ctag-fh-kiel/troll-8/readme.md

CTAG (http://www.creative-technologies.de/troll8/)
# CTAG TROLL8
TROLL8 is an Arduino Based μSynth development platform.
This repo contains:
  - [KiCad](http://kicad.org/) PCB design files ([schematics as pdf](https://github.com/ctag-fh-kiel/troll-8/blob/master/Docs/TROLL-8-Schematics.pdf))
	- You may order the PCB [here](http://dirtypcbs.com/store/designer/details/8229/2509/gerber-zip)
  - Silkscreen design files
  - Arduino examples
    - Midi controller (requires [hairless midi](http://projectgus.github.io/hairless-midiserial/))
	- Drum machine with Synth
    - ePiano (velocity sensitive)    
	- Step sequencer
    - Linear sequencer
    - Teensy 3.1 synthesizer
    - LED example
    - and more...
  - A short [presentation on TROLL8](https://github.com/ctag-fh-kiel/troll-8/blob/master/Docs/Talk_AmIEs2016_Manzke.pdf)
# Known Bugs
  - PCB design: Rotary knobs are not evenly spaced
# Authors / License
  - Authors are Robert Manzke (Main Author, FH-Kiel), Henrik Langer (FH-Kiel), Alexander Konradi (FH-Kiel)
  - Licensed under Creative Commons Attribution-NonCommercial-ShareAlike 4.0 International License
# Acknoledgements
  - All Arduino examples make use of the amazing [Mozzi Sound Library](http://sensorium.github.io/Mozzi/)
# Media
CTAG (https://www.youtube.com/watch?v=BTMn9AdLmPc&t=76s)
av500 (https://www.youtube.com/watch?v=JXBJwmJRRko)
Gearnews German (https://www.gearnews.de/creative-technology-%C2%B5synth/)
## [Gearnews English (click here)](https://www.gearnews.com/troll8-micro-sized-synthesizer-sequencer-controller-drum-machine/)
