ctag-fh-kiel/troll-8/PCB/bom.xlsx

Mouser | Id | Designator | Package | Quantity | Designation | Manuf ID | Notes
x | 1 | C103,C102,C101,C201,C202,C401,C502,C501,C601 | C_0603_HandSoldering | 9 | 100n | C0603C104K5RACTU (https://www.mouser.de/Search/ProductDetail.aspx)
x | 2 | C104, C105 | C_0603_HandSoldering | 2 | 220n | 02016D224KAT2A (http://www.mouser.de/ProductDetail/AVX/02016D224KAT2A/)
x | 3 | C106 | C_0603_HandSoldering | 1 | 1n | GCM188R71H102KA37D (https://www.mouser.de/Search/ProductDetail.aspx)
x | 4 | C301,C302 | c_elec_4x5.7 | 2 | 10u | EEE-FC1C100R (https://www.mouser.de/Search/ProductDetail.aspx)
x | 5 | CON301 | BARELL_CLIFF_DC10L | 1 | BARREL_JACK | PJ-102B (http://www.mouser.de/ProductDetail/CUI/PJ-102B/)
x | 6 | D201,D202,D203,D204,D205,D206,D207,D208,D209,D210,D211,D212,D213,D214,D215,D216,D601,D602,D603,D604,D605,D606,D607,D608 | LED-0603 | 24 | LED | 696-SMLLXFP0603SICTR (http://www.mouser.de/ProductDetail/Lumex/SML-LXFP0603SIC-TR/)
x | 7 | D301 | SOD-123 | 1 | D_Schottky | STPS140Z (https://www.mouser.de/Search/ProductDetail.aspx?R=STPS140Zvirtualkey51120000virtualkey511-STPS140Z)
x | 8 | JP101,JP102 | R_0603_HandSoldering | 2 | Jumper_NC_Small | ERJ-3GEY0R00V (https://www.mouser.de/Search/ProductDetail.aspx)
Thonk | 9 | J101 | Thonkicon | 1 | AUOUT | PJ301M-12 | https://www.thonk.co.uk/shop/3-5mm-jacks/
x | 10 | R102 | R_0603_HandSoldering | 1 | 270 | ERJ3EKF2700V (http://de.farnell.com/panasonic-electronic-components/erj3ekf2700v/dickschichtwiderstand-270r-1-0/dp/2303096)
x | 11 | R103,R104 | R_0603_HandSoldering | 2 | 680 | ERJ3EKF6800V (http://de.farnell.com/panasonic-electronic-components/erj3ekf6800v/dickschichtwiderstand-680r-1-0/dp/2303131)
x | 12 | R105 | R_0603_HandSoldering | 1 | 330 | ERJ3EKF3300V (http://de.farnell.com/panasonic-electronic-components/erj3ekf3300v/dickschichtwiderstand-330r-1-0/dp/2303104)
x | 13 | R201,R501,R502,R503,R101 | R_0603_HandSoldering | 5 | 10k | ERJ3EKF1002V (http://de.farnell.com/panasonic-electronic-components/erj3ekf1002v/dickschichtwiderstand-10k-1-0/dp/2303192)
x | 14 | SW601,SW602,SW603,SW604,SW605,SW606,SW607,SW608 | TE-147873-1-Pushbutton | 8 | SW_PUSH | 147873-1
x | 15 | U102 | TSSOP-16_4.4x5mm_Pitch0.65mm | 1 | 74LVC138 | SN74LVC138APWR (http://www.mouser.de/ProductDetail/Texas-Instruments/SN74LVC138APWR/)
x | 16 | U301 | SOT-23-5 | 1 | MCP1755 | MCP1755T-3302E/OT
x | 17 | U401 | SOIC-16_3.9x9.9mm_Pitch1.27mm | 1 | MCP3208 | MCP3008-I/SL (http://www.mouser.de/ProductDetail/Microchip-Technology/MCP3008-I-SL/?qs=sGAEpiMZZMvcAs5GUBtMdQUZaOjaJnKJ) | Using 10 bit for now
x | 18 | U501 | SOIC-8_3.9x4.9mm_Pitch1.27mm | 1 | SST25VF-FLASH | SST25VF080B-80-4I-SAE (http://www.mouser.de/ProductDetail/Microchip-Technology/SST25VF080B-80-4I-SAE/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)
x | 19 | U502 | SOIC-8_3.9x4.9mm_Pitch1.27mm | 1 | 23LC1024-I/SN | 23LC1024-I/SN
x | 20 | U101 | TSSOP-16_4.4x5mm_Pitch0.65mm | 1 | 4050 | CD74HC4050PWR (http://www.mouser.de/ProductDetail/Texas-Instruments/CD74HC4050PWR/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)
x | 21 | U201,U204,U602 | EXBA10P | 3 | EXBA10P-RES | EXB-A10P471J | EXB-A10P331J auch kaufen
x | 22 | P101 | Pin_Header_Straight_2x04 | 1 | SPI_EXT | M20-7830446 (https://www.mouser.de/Search/ProductDetail.aspx)
x | 23 | P102,P103 | Pin_Header_Straight_1x15 | 2 | ~ | M20-7821546
x | 24 | U202,U205 | QFN-24-1EP_4x4mm_Pitch0.5mm | 2 | CAP1188 | CAP1188-1-CP-TR
x | 25 | U601 | QFN-24-1EP_4x4mm_Pitch0.5mm | 1 | MCP23S18-GPIO-QFN-OPEN_DRAIN | MCP23S18-E/MJ
x | 26 | JP103,JP104 | R_0805_HandSoldering | 2 | Jumper_NC_Small | RC0805JR-070RL (https://www.mouser.de/Search/ProductDetail.aspx)
x | 27 | RV401,RV402,RV403,RV404,RV405,RV406,RV407,RV408 | Alps-RK09 | 8 | POT | RK09K1130081 | With center dip
x
