ctag-fh-kiel/troll-8/PCB/troll-8.kicad_pcb

## KiCad design PCB/troll-8.kicad_pcb (2017-11-28)

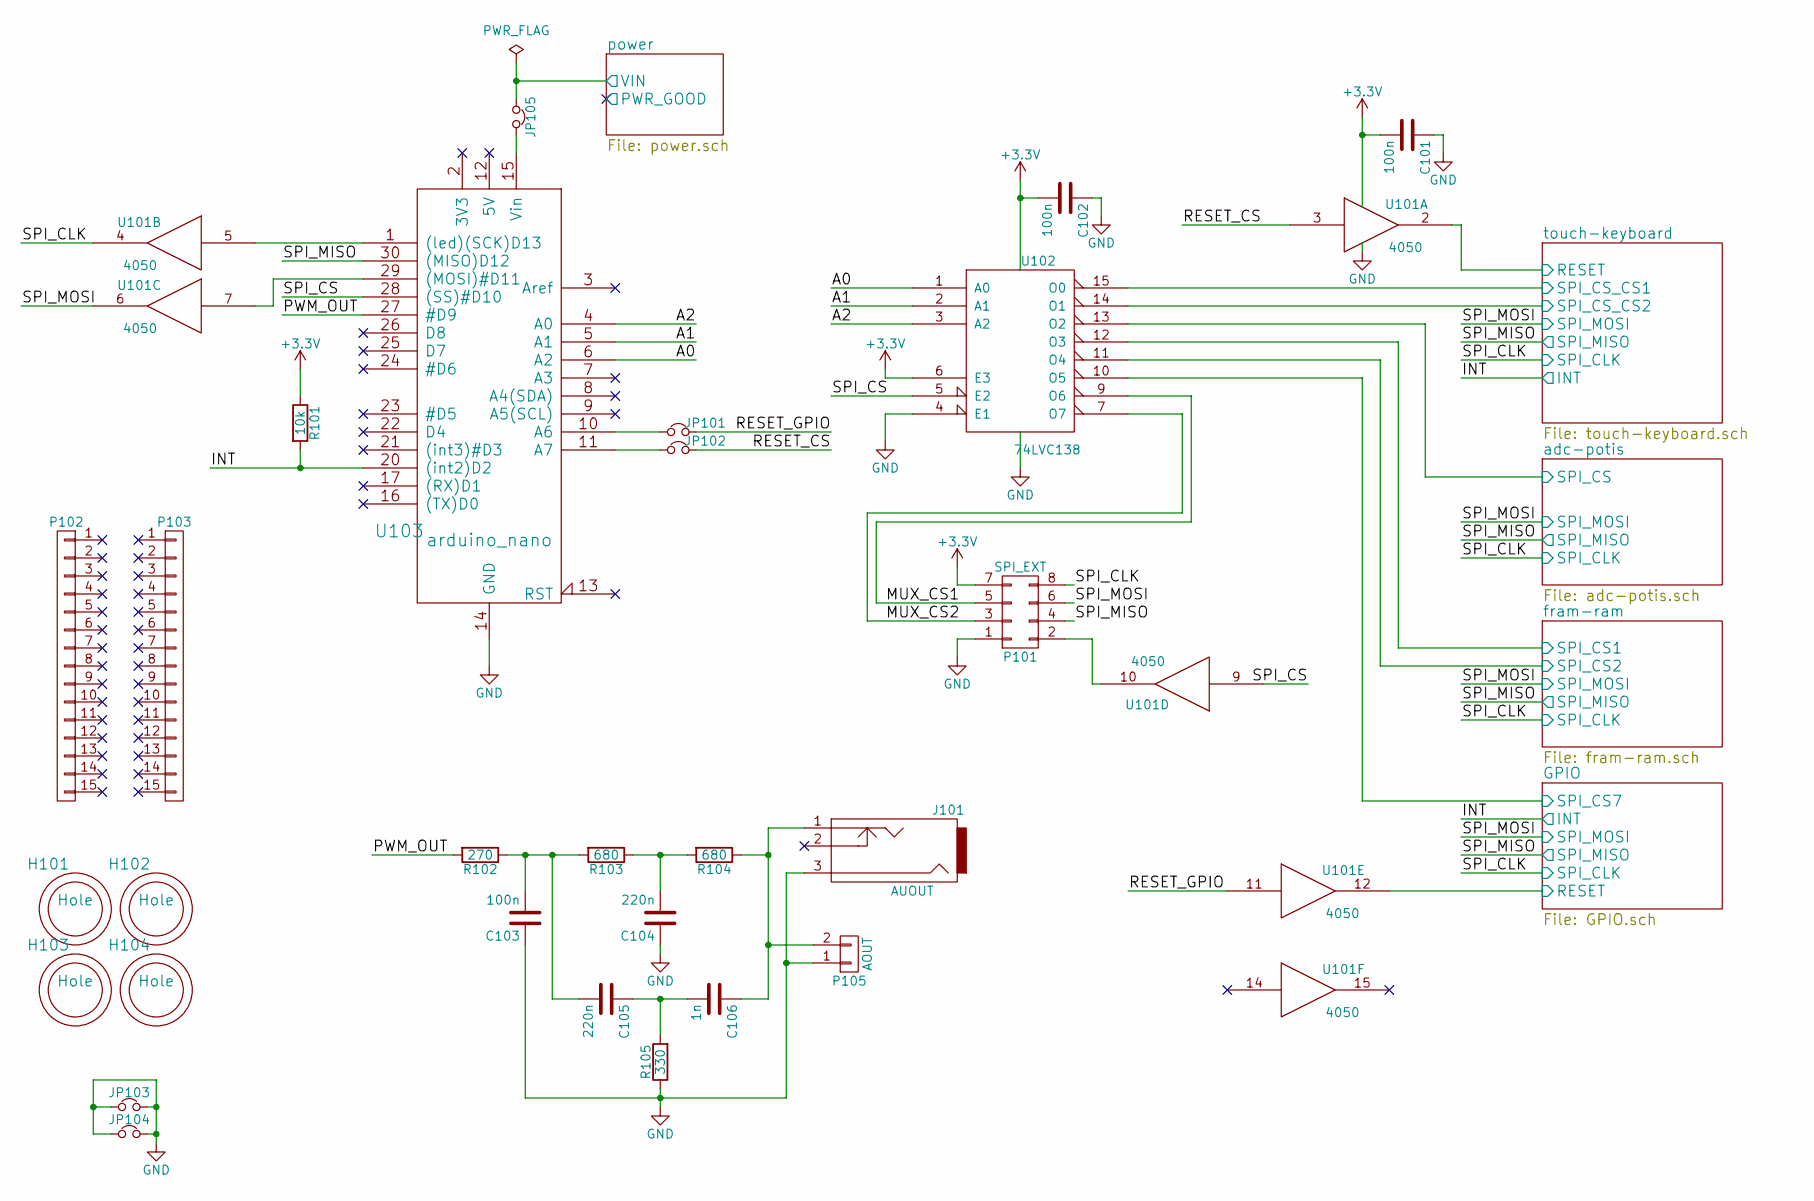
[picture p11: schematic troll-8.sch, CTAG TROLL8]

Parts:
C101, C102, C103: 100n; C_0603_HandSoldering
C104, C105: 220n; C_0603_HandSoldering
C106: 1n; C_0603_HandSoldering
H101, H102, H103, H104: Hole; Hole_3mm
J101: AUOUT; THONKICONN
JP101, JP102: Jumper_NC_Small; R_0603_HandSoldering
JP103, JP104: Jumper_NC_Small; R_0805_HandSoldering
JP105: Jumper_NC_Small; Pin_Header_Straight_1x02
P101: SPI_EXT; Pin_Header_Straight_2x04
P102, P103: Pin_Header_Straight_1x15
P105: AOUT; Pin_Header_Straight_1x02
R101: 10k; R_0603_HandSoldering
R102: 270; R_0603_HandSoldering
R103, R104: 680; R_0603_HandSoldering
R105: 330; R_0603_HandSoldering
U101: 4050; TSSOP-16_4.4x5mm_Pitch0.65mm
U102: 74LVC138; TSSOP-16_4.4x5mm_Pitch0.65mm
U103: arduino_nano; arduino_mini

Connections:
+3V3: C101.2, C102.2, P101.7, R101.1, U101.1 (VCC), U102.6 (E3), U102.16 (VCC); also elsewhere on the board
/A0: U102.1 (A0), U103.6 (A2)
/A1: U102.2 (A1), U103.5 (A1)
/A2: U102.3 (A2), U103.4 (A0)
/GPIO/RESET: U101.12; also elsewhere on the board
/GPIO/SPI_CS7: U102.10 (O5); also elsewhere on the board
/INT: R101.2, U103.20 ((int2)D2); also elsewhere on the board
/MUX_CS1: P101.5, U102.9 (O6)
/MUX_CS2: P101.3, U102.7 (O7)
/PWM_OUT: R102.2, U103.27 (#D9)
/RESET_CS: JP102.2, U101.3
/RESET_GPIO: JP101.2, U101.11
/SPI_CLK: P101.8, U101.4; also elsewhere on the board
/SPI_CS: U101.9, U102.5 (E2), U103.28 ((SS)#D10)
/SPI_MISO: P101.4, U103.30 ((MISO)D12); also elsewhere on the board
/SPI_MOSI: P101.6, U101.6; also elsewhere on the board
/adc-potis/SPI_CS: U102.13 (O2); also elsewhere on the board
/fram-ram/SPI_CS1: U102.12 (O3); also elsewhere on the board
/fram-ram/SPI_CS2: U102.11 (O4); also elsewhere on the board
/power/VIN: JP105.1; also elsewhere on the board
/touch-keyboard/RESET: U101.2; also elsewhere on the board
/touch-keyboard/SPI_CS_CS1: U102.15 (O0); also elsewhere on the board
/touch-keyboard/SPI_CS_CS2: U102.14 (O1); also elsewhere on the board
GND: C101.1, C102.1, C103.1, C104.1, J101.3, JP103.1, JP103.2, JP104.1, JP104.2, P101.1, P105.1, R105.1, U101.8 (VSS), U102.4 (E1), U102.8 (GND), U103.14 (GND), U103.19 (GND); also elsewhere on the board
unnamed: C103.2, C105.2, R102.1, R103.2
unnamed: C104.2, R103.1, R104.2
unnamed: C105.1, C106.2, R105.2
unnamed: C106.1, J101.1, P105.2, R104.1
unnamed: JP101.1, U103.10 (A6)
unnamed: JP102.1, U103.11 (A7)
unnamed: JP105.2, U103.15 (Vin)
unnamed: P101.2, U101.10
unnamed: U101.5, U103.1 ((led)(SCK)D13)
unnamed: U101.7, U103.29 ((MOSI)#D11)

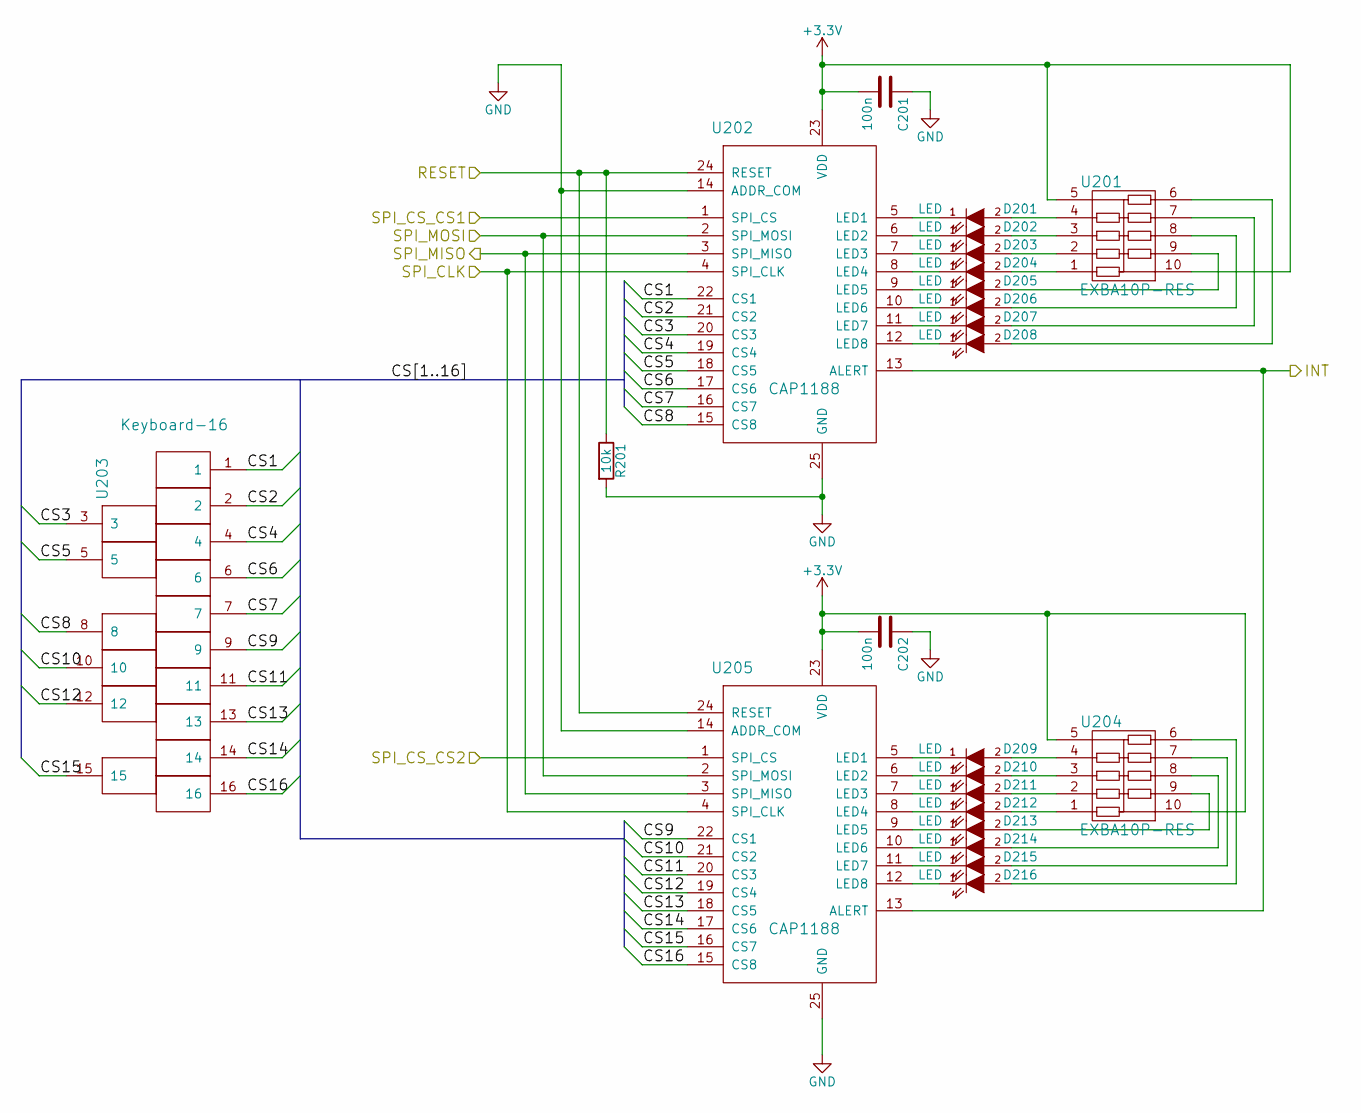
[picture p12: schematic touch-keyboard.sch, CTAG TROLL8]

Parts:
C201, C202: 100n; C_0603_HandSoldering
D201, D202, D203, D204, D205, D206, D207, D208, D209, D210, D211, D212, D213, D214, D215, D216: LED; LED-0603
R201: 10k; R_0603_HandSoldering
U201, U204: EXBA10P-RES; EXBA10P
U202, U205: CAP1188; QFN-24-1EP_4x4mm_Pitch0.5mm
U203: Keyboard-16; midi-keyboard-16

Connections:
+3V3: C201.2, C202.2, U201.5, U201.10, U202.23 (VDD), U204.5, U204.10, U205.23 (VDD); also elsewhere on the board
/INT: U202.13 (ALERT), U205.13 (ALERT); also elsewhere on the board
/SPI_CLK: U202.4 (SPI_CLK), U205.4 (SPI_CLK); also elsewhere on the board
/SPI_MISO: U202.3 (SPI_MISO), U205.3 (SPI_MISO); also elsewhere on the board
/SPI_MOSI: U202.2 (SPI_MOSI), U205.2 (SPI_MOSI); also elsewhere on the board
/touch-keyboard/CS1: U202.22 (CS1), U203.1
/touch-keyboard/CS2: U202.21 (CS2), U203.2
/touch-keyboard/CS3: U202.20 (CS3), U203.3
/touch-keyboard/CS4: U202.19 (CS4), U203.4
/touch-keyboard/CS5: U202.18 (CS5), U203.5
/touch-keyboard/CS6: U202.17 (CS6), U203.6
/touch-keyboard/CS7: U202.16 (CS7), U203.7
/touch-keyboard/CS8: U202.15 (CS8), U203.8
/touch-keyboard/CS9: U203.9, U205.22 (CS1)
/touch-keyboard/CS10: U203.10, U205.21 (CS2)
/touch-keyboard/CS11: U203.11, U205.20 (CS3)
/touch-keyboard/CS12: U203.12, U205.19 (CS4)
/touch-keyboard/CS13: U203.13, U205.18 (CS5)
/touch-keyboard/CS14: U203.14, U205.17 (CS6)
/touch-keyboard/CS15: U203.15, U205.16 (CS7)
/touch-keyboard/CS16: U203.16, U205.15 (CS8)
/touch-keyboard/RESET: R201.1, U202.24 (RESET), U205.24 (RESET); also elsewhere on the board
/touch-keyboard/SPI_CS_CS1: U202.1 (SPI_CS); also elsewhere on the board
/touch-keyboard/SPI_CS_CS2: U205.1 (SPI_CS); also elsewhere on the board
GND: C201.1, C202.1, R201.2, U202.14 (ADDR_COM), U202.25 (GND), U205.14 (ADDR_COM), U205.25 (GND); also elsewhere on the board
unnamed: D201.1 (K), U202.5 (LED1)
unnamed: D201.2 (A), U201.4
unnamed: D202.1 (K), U202.6 (LED2)
unnamed: D202.2 (A), U201.3
unnamed: D203.1 (K), U202.7 (LED3)
unnamed: D203.2 (A), U201.2
unnamed: D204.1 (K), U202.8 (LED4)
unnamed: D204.2 (A), U201.1
unnamed: D205.1 (K), U202.9 (LED5)
unnamed: D205.2 (A), U201.9
unnamed: D206.1 (K), U202.10 (LED6)
unnamed: D206.2 (A), U201.8
unnamed: D207.1 (K), U202.11 (LED7)
unnamed: D207.2 (A), U201.7
unnamed: D208.1 (K), U202.12 (LED8)
unnamed: D208.2 (A), U201.6
unnamed: D209.1 (K), U205.5 (LED1)
unnamed: D209.2 (A), U204.4
unnamed: D210.1 (K), U205.6 (LED2)
unnamed: D210.2 (A), U204.3
unnamed: D211.1 (K), U205.7 (LED3)
unnamed: D211.2 (A), U204.2
unnamed: D212.1 (K), U205.8 (LED4)
unnamed: D212.2 (A), U204.1
unnamed: D213.1 (K), U205.9 (LED5)
unnamed: D213.2 (A), U204.9
unnamed: D214.1 (K), U205.10 (LED6)
unnamed: D214.2 (A), U204.8
unnamed: D215.1 (K), U205.11 (LED7)
unnamed: D215.2 (A), U204.7
unnamed: D216.1 (K), U205.12 (LED8)
unnamed: D216.2 (A), U204.6

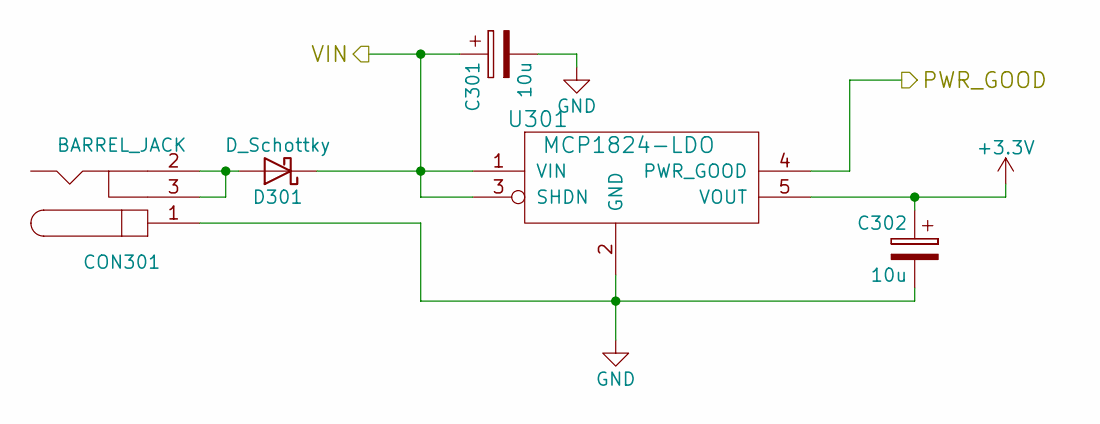
[picture p13: schematic power.sch, CTAG TROLL8]

Parts:
C301, C302: 10u; c_elec_4x5.7
CON301: BARREL_JACK; BARELL_CLIFF_DC10L
D301: D_Schottky; SOD-123
U301: MCP1824-LDO; SOT-23-5

Connections:
+3V3: C302.1, U301.5 (VOUT); also elsewhere on the board
/power/PWR_GOOD: U301.4 (PWR_GOOD)
/power/VIN: C301.1, D301.1 (K), U301.1 (VIN), U301.3 (SHDN); also elsewhere on the board
GND: C301.2, C302.2, CON301.1, U301.2 (GND); also elsewhere on the board
unnamed: CON301.2, CON301.3, D301.2 (A)

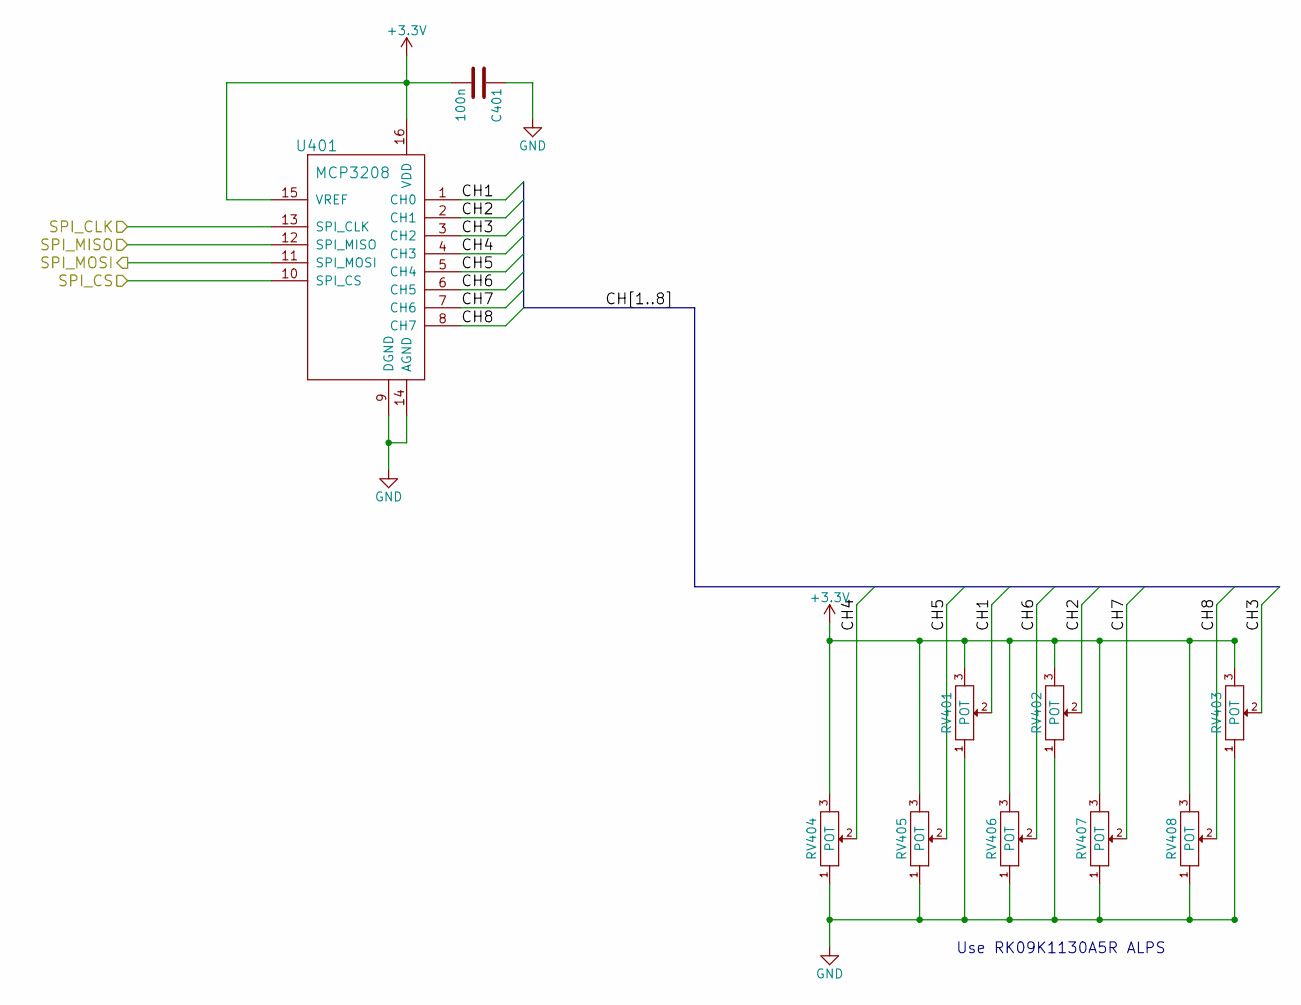
[picture p14: schematic adc-potis.sch, CTAG TROLL8]

Parts:
C401: 100n; C_0603_HandSoldering
RV401, RV402, RV403, RV404, RV405, RV406, RV407, RV408: POT; Alps-RK09
U401: MCP3208; SOIC-16_3.9x9.9mm_Pitch1.27mm

Connections:
+3V3: C401.2, RV401.3, RV402.3, RV403.3, RV404.3, RV405.3, RV406.3, RV407.3, RV408.3, U401.15 (VREF), U401.16 (VDD); also elsewhere on the board
/SPI_CLK: U401.13 (SPI_CLK); also elsewhere on the board
/SPI_MISO: U401.12 (SPI_MISO); also elsewhere on the board
/SPI_MOSI: U401.11 (SPI_MOSI); also elsewhere on the board
/adc-potis/CH1: RV401.2, U401.1 (CH0)
/adc-potis/CH2: RV402.2, U401.2 (CH1)
/adc-potis/CH3: RV403.2, U401.3 (CH2)
/adc-potis/CH4: RV404.2, U401.4 (CH3)
/adc-potis/CH5: RV405.2, U401.5 (CH4)
/adc-potis/CH6: RV406.2, U401.6 (CH5)
/adc-potis/CH7: RV407.2, U401.7 (CH6)
/adc-potis/CH8: RV408.2, U401.8 (CH7)
/adc-potis/SPI_CS: U401.10 (SPI_CS); also elsewhere on the board
GND: C401.1, RV401.1, RV402.1, RV403.1, RV404.1, RV405.1, RV406.1, RV407.1, RV408.1, U401.9 (DGND), U401.14 (AGND); also elsewhere on the board

Notes on the sheet:
Use RK09K1130A5R ALPS

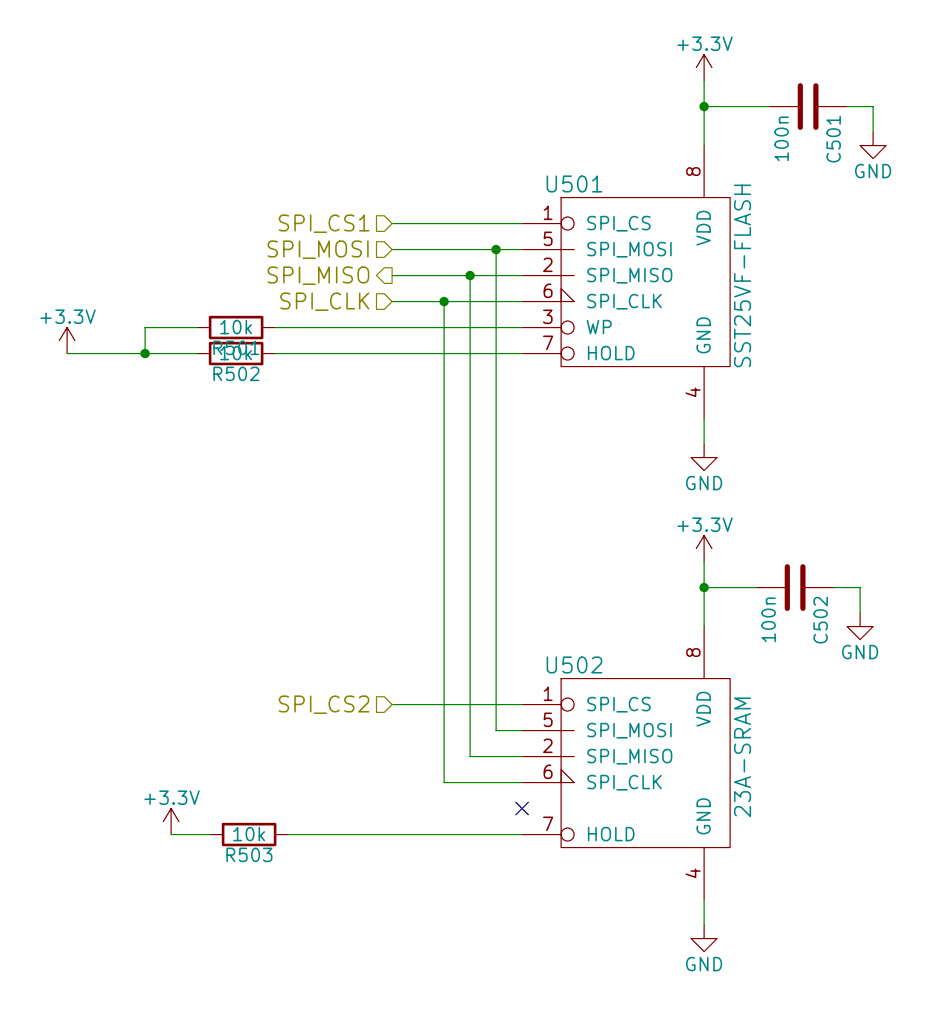
[picture p15: schematic fram-ram.sch, CTAG TROLL8]

Parts:
C501, C502: 100n; C_0603_HandSoldering
R501, R502, R503: 10k; R_0603_HandSoldering
U501: SST25VF-FLASH; SOIC-8_3.9x4.9mm_Pitch1.27mm
U502: 23A-SRAM; SOIC-8_3.9x4.9mm_Pitch1.27mm

Connections:
+3V3: C501.2, C502.2, R501.2, R502.2, R503.2, U501.8 (VDD), U502.8 (VDD); also elsewhere on the board
/SPI_CLK: U501.6 (SPI_CLK), U502.6 (SPI_CLK); also elsewhere on the board
/SPI_MISO: U501.2 (SPI_MISO), U502.2 (SPI_MISO); also elsewhere on the board
/SPI_MOSI: U501.5 (SPI_MOSI), U502.5 (SPI_MOSI); also elsewhere on the board
/fram-ram/SPI_CS1: U501.1 (SPI_CS); also elsewhere on the board
/fram-ram/SPI_CS2: U502.1 (SPI_CS); also elsewhere on the board
GND: C501.1, C502.1, U501.4 (GND), U502.4 (GND); also elsewhere on the board
unnamed: R501.1, U501.3 (WP)
unnamed: R502.1, U501.7 (HOLD)
unnamed: R503.1, U502.7 (HOLD)

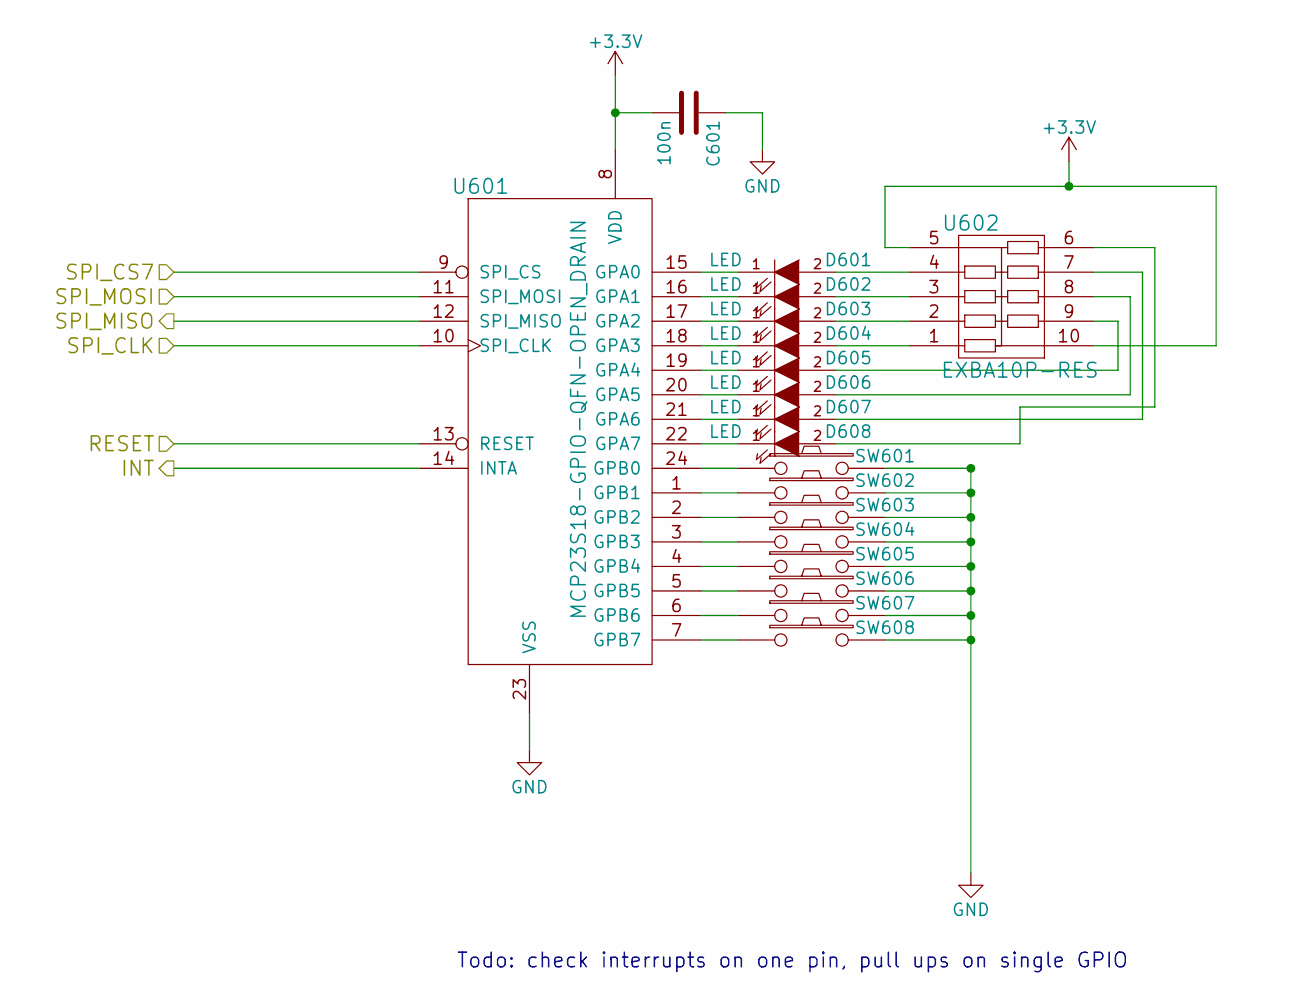
[picture p16: schematic GPIO.sch, CTAG TROLL8]

Parts:
C601: 100n; C_0603_HandSoldering
D601, D602, D603, D604, D605, D606, D607, D608: LED; LED-0603
SW601, SW602, SW603, SW604, SW605, SW606, SW607, SW608: SW_PUSH; TE-147873-1-Pushbutton
U601: MCP23S18-GPIO-QFN-OPEN_DRAIN; QFN-24-1EP_4x4mm_Pitch0.5mm
U602: EXBA10P-RES; EXBA10P

Connections:
+3V3: C601.2, U601.8 (VDD), U602.5, U602.10; also elsewhere on the board
/GPIO/RESET: U601.13 (RESET); also elsewhere on the board
/GPIO/SPI_CS7: U601.9 (SPI_CS); also elsewhere on the board
/INT: U601.14 (INTA); also elsewhere on the board
/SPI_CLK: U601.10 (SPI_CLK); also elsewhere on the board
/SPI_MISO: U601.12 (SPI_MISO); also elsewhere on the board
/SPI_MOSI: U601.11 (SPI_MOSI); also elsewhere on the board
GND: C601.1, SW601.2, SW602.2, SW603.2, SW604.2, SW605.2, SW606.2, SW607.2, SW608.2, U601.23 (VSS); also elsewhere on the board
unnamed: D601.1 (K), U601.15 (GPA0)
unnamed: D601.2 (A), U602.4
unnamed: D602.1 (K), U601.16 (GPA1)
unnamed: D602.2 (A), U602.3
unnamed: D603.1 (K), U601.17 (GPA2)
unnamed: D603.2 (A), U602.2
unnamed: D604.1 (K), U601.18 (GPA3)
unnamed: D604.2 (A), U602.1
unnamed: D605.1 (K), U601.19 (GPA4)
unnamed: D605.2 (A), U602.9
unnamed: D606.1 (K), U601.20 (GPA5)
unnamed: D606.2 (A), U602.8
unnamed: D607.1 (K), U601.21 (GPA6)
unnamed: D607.2 (A), U602.7
unnamed: D608.1 (K), U601.22 (GPA7)
unnamed: D608.2 (A), U602.6
unnamed: SW601.1, U601.24 (GPB0)
unnamed: SW602.1, U601.1 (GPB1)
unnamed: SW603.1, U601.2 (GPB2)
unnamed: SW604.1, U601.3 (GPB3)
unnamed: SW605.1, U601.4 (GPB4)
unnamed: SW606.1, U601.5 (GPB5)
unnamed: SW607.1, U601.6 (GPB6)
unnamed: SW608.1, U601.7 (GPB7)

Notes on the sheet:
Todo: check interrupts on one pin, pull ups on single GPIO

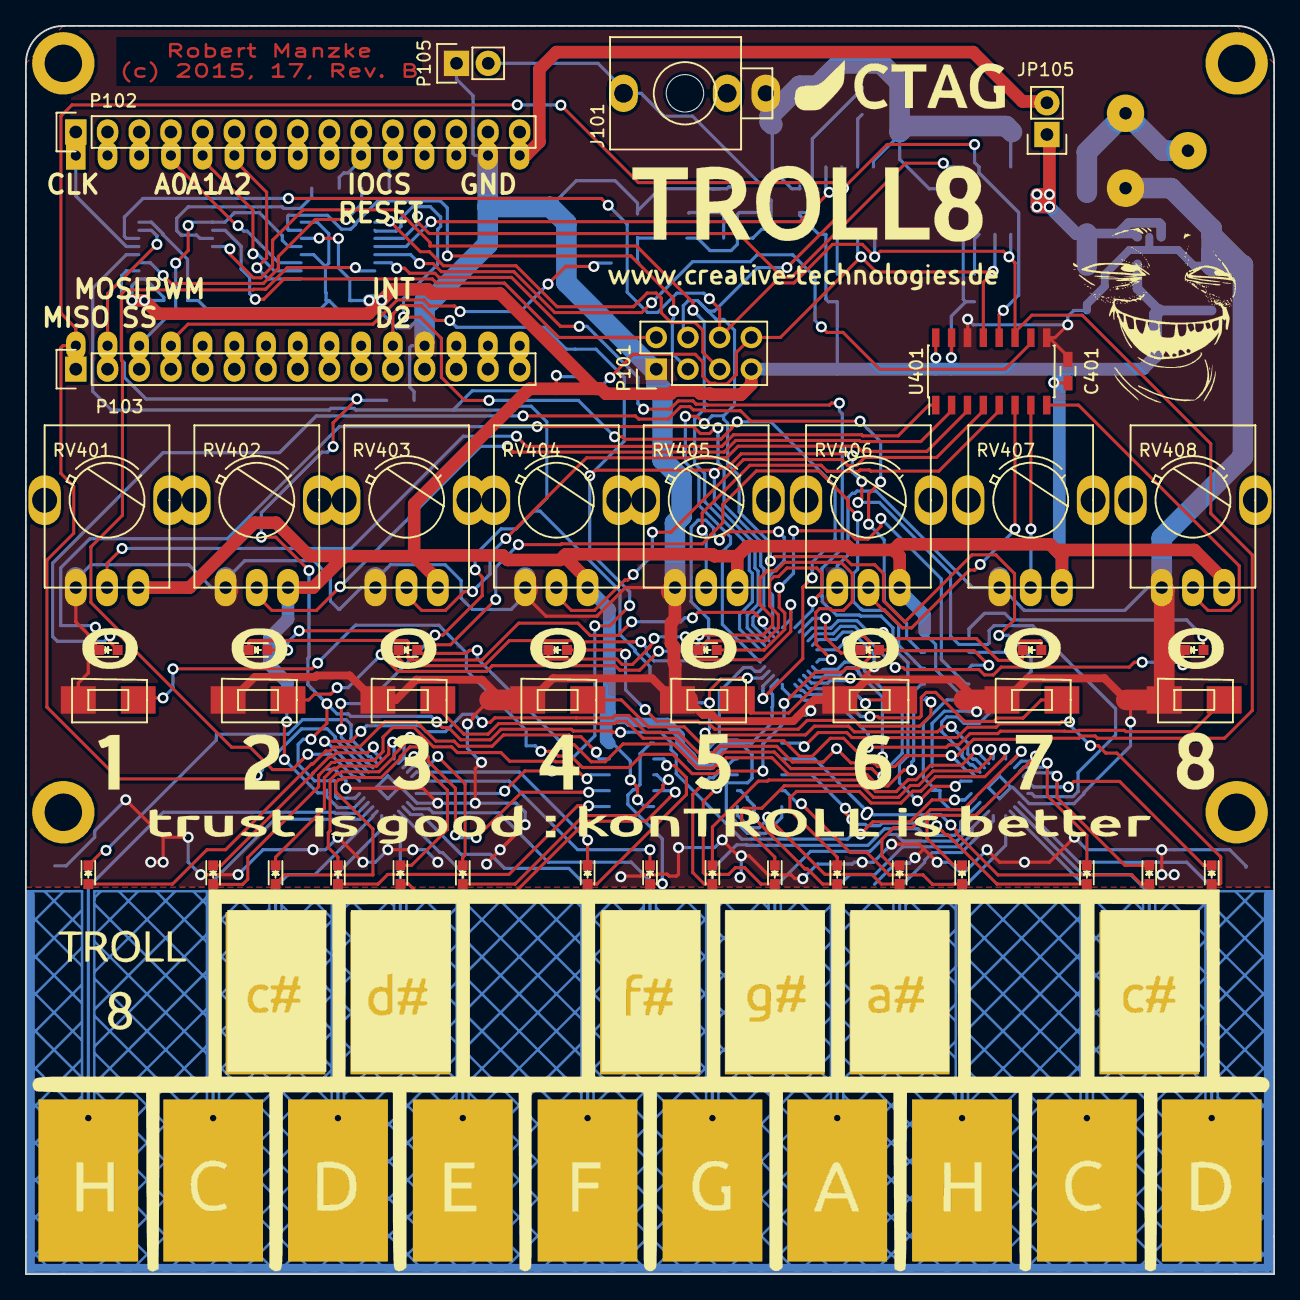
[picture p17: board troll-8.kicad_pcb from above]

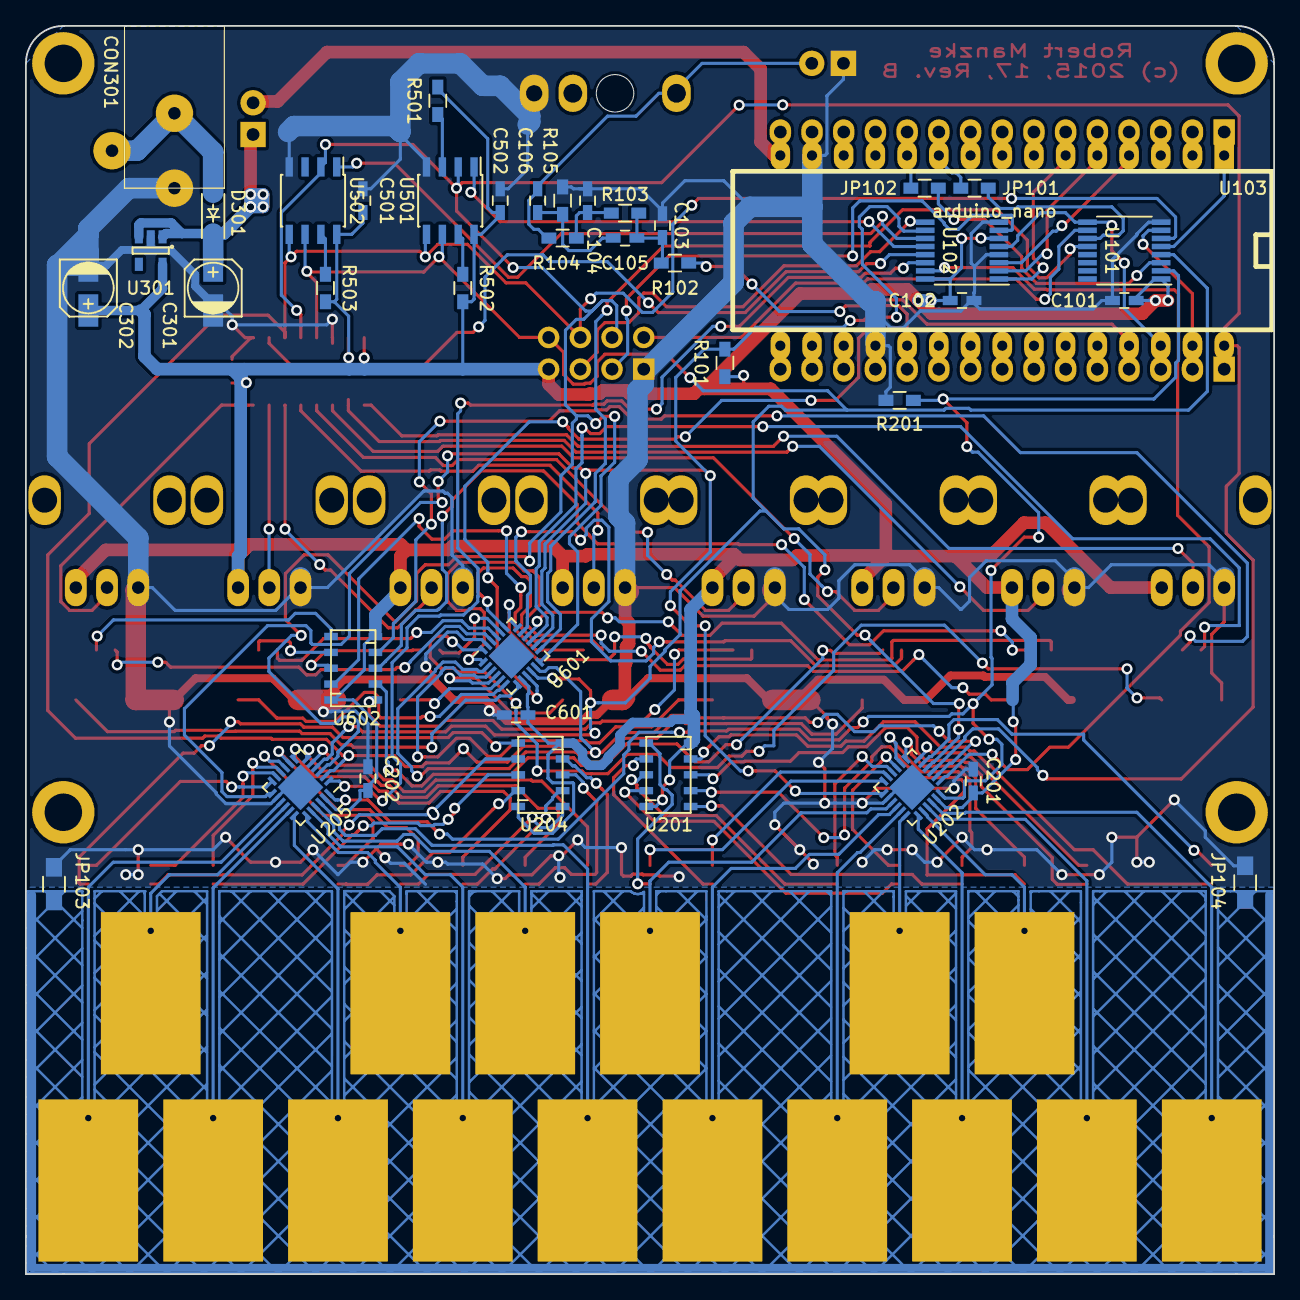
[picture p18: board troll-8.kicad_pcb from below]

Board: 2 copper layers, 100.0 x 100.0 mm, 93 parts (40 on the bottom side), 118 nets.
