ctag-fh-kiel/troll-8/Code/Synthesizer/notes.h

#ifndef NOTES_FREQUENCY_H_
#define NOTES_FREQUENCY_H_

//Beginning with C0
const float notes_frequency_DATA [] = {
	16.35f, //C0
	17.32f,
	18.35f,
	19.45f,
	20.60f,
	21.83f,
	23.12f,
	24.50f,
	25.96f,
	27.50f,
	29.14f,
	30.87f,
	32.70f, //C1
	34.65f,
	36.71f,
	38.89f,
	41.20f,
	43.65f,
	46.25f,
	49.00f,
	51.91f,
	55.00f,
	58.27f,
	61.74f,
	65.41f, //C2
	69.30f,
	73.42f,
	77.78f,
	82.41f,
	87.31f,
	92.50f,
	98.00f,
	103.83f,
	110.00f,
	116.54f,
	123.47f,
	130.81f, //C3
	138.59f,
	146.83f,
	155.56f,
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
};

#endif /* NOTES_FREQUENCY_H_ */
