ctag-fh-kiel/troll-8/(commit log)

2017-04-16 added pdf of schematics
    [GPIO.sch, adc-potis.sch, fram-ram.sch, power.sch, touch-keyboard.sch, troll-8.sch]
2017-11-28 redesign, logo and audio connector changed
    [bom.xlsx, troll-8.kicad_pcb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]
2017-11-28 small changes silk screen
    [troll-8.kicad_pcb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]
2021-11-08 Update readme.md
    https://forum.kicad.info/t/warning-avoid-all-links-to-kicad-pcb-org-use-kicad-org/31521
