ctag-fh-kiel/troll-8/(notices)

Notices in the files:
PCB/adc-potis.sch:
Licensed under a Creative Commons Attribution-NonCommercial-ShareAlike 4.0
PCB/troll-8.kicad_pcb:
(c) 2015, 17, Rev. B
